TonySico/Split-Ergonomic-Keyboard/README.md

# Split-Ergonomic-Keyboard

All the files contained here are meant for public use and as a learning opportunity for those interested in creating their own custom AVR-based firmware from scratch without the use of libraries.
