TonySico/Split-Ergonomic-Keyboard/keyboard/firmware/README

Place all firmware needed to re-flash a board here
