TonySico/Split-Ergonomic-Keyboard/kicad/Left_Half_v1/Left_Half_v1.kicad_pcb

## KiCad design kicad/Left_Half_v1/Left_Half_v1.kicad_pcb (2025-06-17, last stored version)

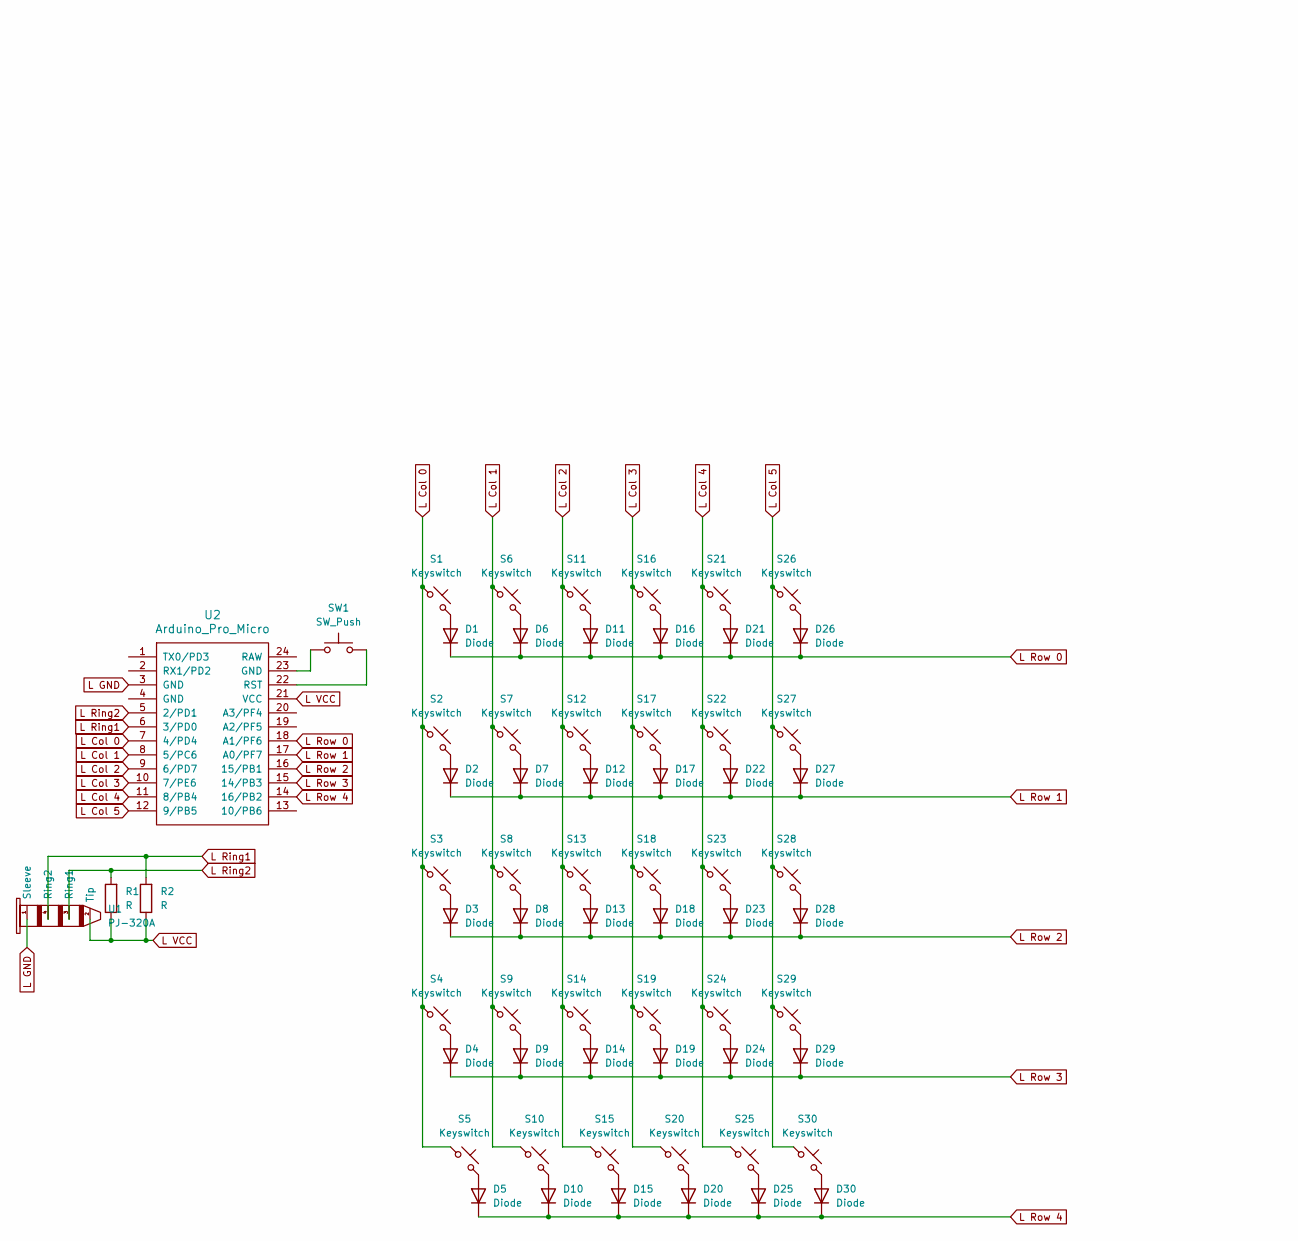
[picture p1: schematic Left_Half_v1.kicad_sch, part in row 1, column 1]

Parts:
D1, D2, D3, D4, D5, D6, D7, D8, D9, D10, D11, D12, D13, D14, D15, D16, D17, D18, D19, D20, D21, D22, D23, D24, D25, D26, D27, D28, D29, D30: Diode; D_DO-35_SOD27_P7.62mm_Horizontal
R1, R2: R; R_Axial_DIN0204_L3.6mm_D1.6mm_P5.08mm_Horizontal
S1, S2, S3, S4, S5, S6, S7, S8, S9, S10, S11, S12, S13, S14, S15, S16, S17, S18, S19, S20, S21, S22, S23, S24, S25, S26, S27, S28, S29, S30: Keyswitch; SW_choc_MxCombo_1u
SW1: SW_Push; SW_PUSH_6mm
U1: PJ-320A
U2: Arduino_Pro_Micro

Connections:
L Col 0: S1.1, S2.1, S3.1, S4.1, S5.1, U2.7 (4/PD4)
L Col 1: S6.1, S7.1, S8.1, S9.1, S10.1, U2.8 (5/PC6)
L Col 2: S11.1, S12.1, S13.1, S14.1, S15.1, U2.9 (6/PD7)
L Col 3: S16.1, S17.1, S18.1, S19.1, S20.1, U2.10 (7/PE6)
L Col 4: S21.1, S22.1, S23.1, S24.1, S25.1, U2.11 (8/PB4)
L Col 5: S26.1, S27.1, S28.1, S29.1, S30.1, U2.12 (9/PB5)
L GND: U1.1 (Sleeve), U2.3 (GND)
L Ring1: R2.2, U1.4 (Ring2), U2.6 (3/PD0)
L Ring2: R1.2, U1.3 (Ring1), U2.5 (2/PD1)
L Row 0: D1.1 (K), D6.1 (K), D11.1 (K), D16.1 (K), D21.1 (K), D26.1 (K), U2.18 (A1/PF6)
L Row 1: D2.1 (K), D7.1 (K), D12.1 (K), D17.1 (K), D22.1 (K), D27.1 (K), U2.17 (A0/PF7)
L Row 2: D3.1 (K), D8.1 (K), D13.1 (K), D18.1 (K), D23.1 (K), D28.1 (K), U2.16 (15/PB1)
L Row 3: D4.1 (K), D9.1 (K), D14.1 (K), D19.1 (K), D24.1 (K), D29.1 (K), U2.15 (14/PB3)
L Row 4: D5.1 (K), D10.1 (K), D15.1 (K), D20.1 (K), D25.1 (K), D30.1 (K), U2.14 (16/PB2)
L VCC: R1.1, R2.1, U1.2 (Tip), U2.21 (VCC)
unnamed: D1.2 (A), S1.2
unnamed: D2.2 (A), S2.2
unnamed: D3.2 (A), S3.2
unnamed: D4.2 (A), S4.2
unnamed: D5.2 (A), S5.2
unnamed: D6.2 (A), S6.2
unnamed: D7.2 (A), S7.2
unnamed: D8.2 (A), S8.2
unnamed: D9.2 (A), S9.2
unnamed: D10.2 (A), S10.2
unnamed: D11.2 (A), S11.2
unnamed: D12.2 (A), S12.2
unnamed: D13.2 (A), S13.2
unnamed: D14.2 (A), S14.2
unnamed: D15.2 (A), S15.2
unnamed: D16.2 (A), S16.2
unnamed: D17.2 (A), S17.2
unnamed: D18.2 (A), S18.2
unnamed: D19.2 (A), S19.2
unnamed: D20.2 (A), S20.2
unnamed: D21.2 (A), S21.2
unnamed: D22.2 (A), S22.2
unnamed: D23.2 (A), S23.2
unnamed: D24.2 (A), S24.2
unnamed: D25.2 (A), S25.2
unnamed: D26.2 (A), S26.2
unnamed: D27.2 (A), S27.2
unnamed: D28.2 (A), S28.2
unnamed: D29.2 (A), S29.2
unnamed: D30.2 (A), S30.2
unnamed: SW1.1, U2.23 (GND)
unnamed: SW1.2, U2.22 (RST)

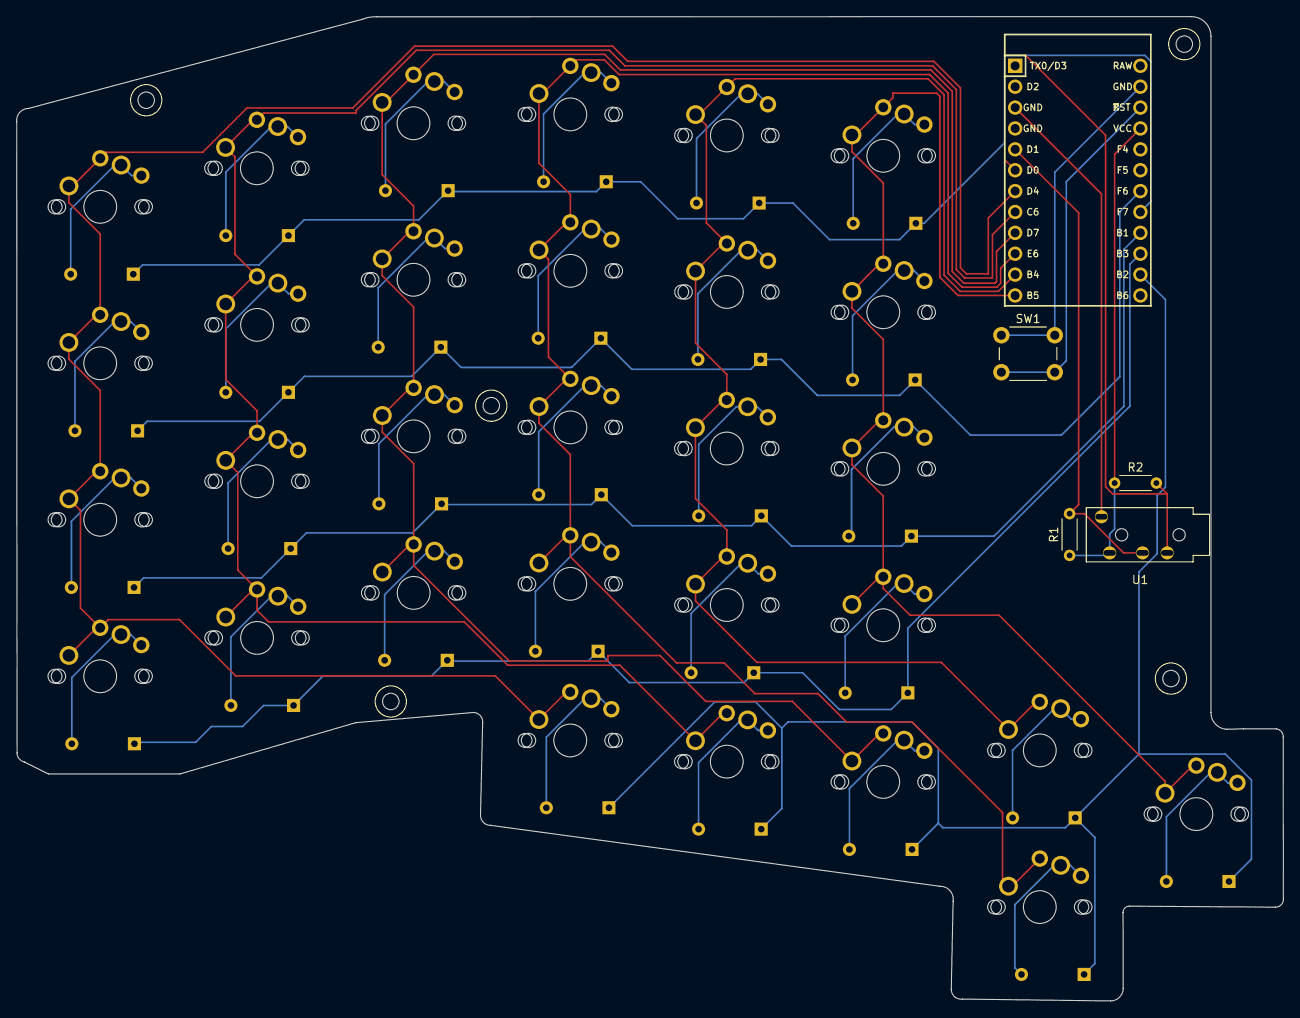
[picture p2: board Left_Half_v1.kicad_pcb from above]

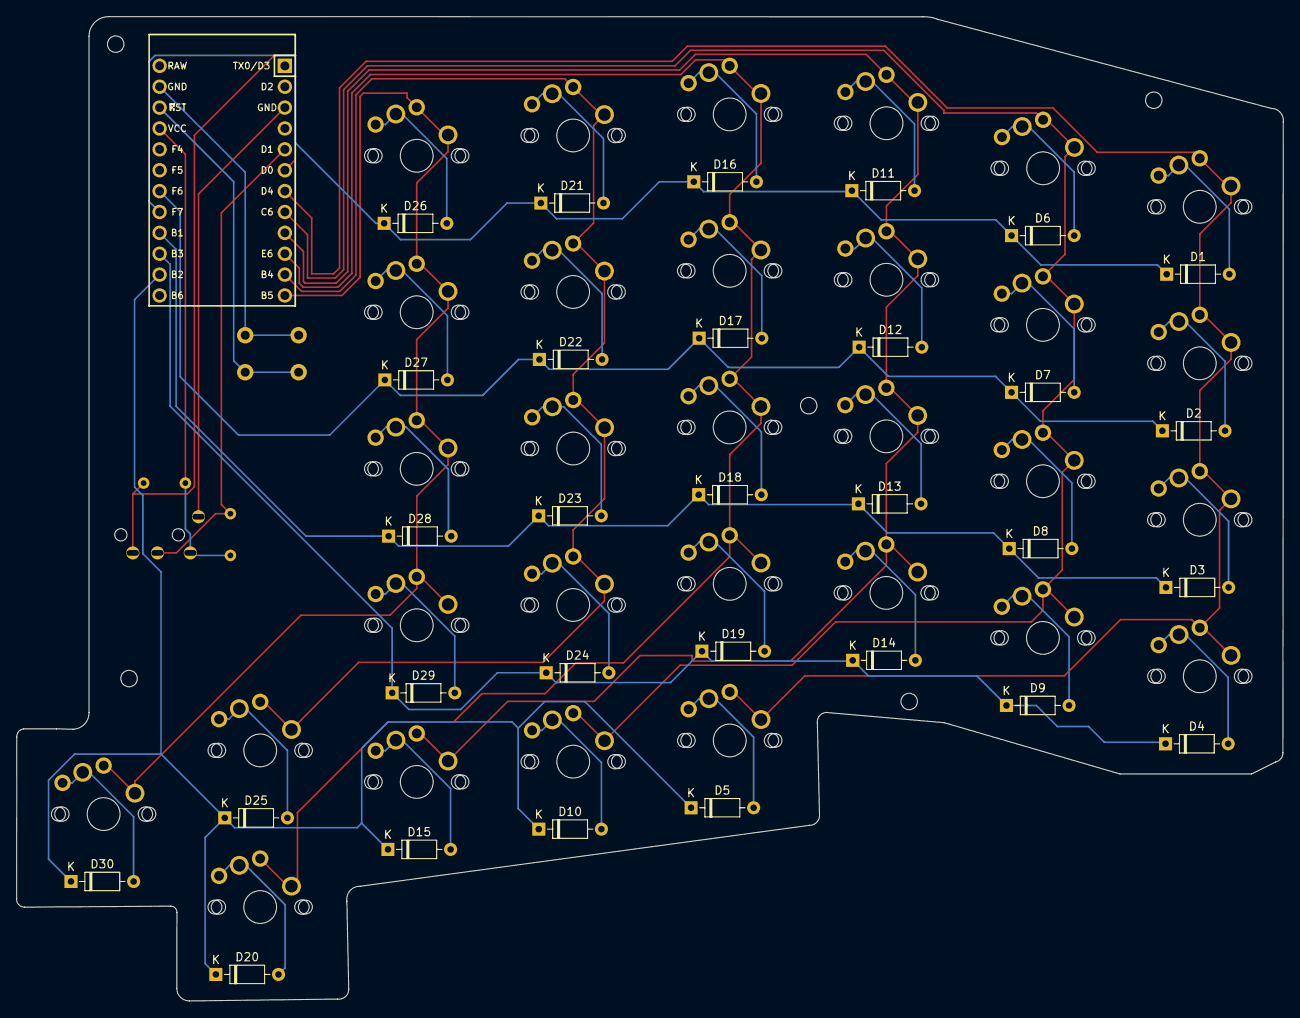
[picture p3: board Left_Half_v1.kicad_pcb from below]

Board: 2 copper layers, 154.1 x 119.8 mm, 65 parts (30 on the bottom side), 47 nets.
