TonySico/Split-Ergonomic-Keyboard/(commit log)

2025-06-17 [add] Source code
    [KeyBoard_2nd_half-B_Cu.gbr, KeyBoard_2nd_half-B_Mask.gbr, KeyBoard_2nd_half-B_Paste.gbr, KeyBoard_2nd_half-B_Silkscreen.gbr, KeyBoard_2nd_half-Edge_Cuts.gbr, KeyBoard_2nd_half-F_Cu.gbr, KeyBoard_2nd_half-F_Mask.gbr, KeyBoard_2nd_half-F_Paste.gbr]
2025-06-17 [add] remove PCB
    [KeyBoard_2nd_half-B_Cu.gbr, KeyBoard_2nd_half-B_Mask.gbr, KeyBoard_2nd_half-B_Paste.gbr, KeyBoard_2nd_half-B_Silkscreen.gbr, KeyBoard_2nd_half-Edge_Cuts.gbr, KeyBoard_2nd_half-F_Cu.gbr, KeyBoard_2nd_half-F_Mask.gbr, KeyBoard_2nd_half-F_Paste.gbr]
2025-08-06 [add] progress debugging i2c stalls
    [helper.h, i2c.c, i2c.h, main_master.c, main_slave.c, mapping.c, usb.c, usb.h]
2025-08-07 [fix] Working i2c on resets
    [i2c.c, usb.c]
2025-08-11 [add] start of layers and fix i2c
    [keycode.h, main_master.c, mapping.c, usb.c, usb.h]
